vvt/GreenhouseProject/README.md

<h1>Introduction/Вступление</h1>

Arduino based smart greenhouse - is the project, intended to provide fully automatic way to control your greenhouse with many tasty features, like MQTT, Wi-Fi, Web-based interface, IoT (ThingSpeak, GardenBoss.ru), configuration software and so on.

Умная теплица на Arduino - проект прошивки, позволяющей вам полностью автоматизировать вашу теплицу, и включающий в себя многие вкусные плюшки, такие как поддержка MQTT, работу через Wi-Fi, работу с IoT (ThingSpeak, GardenBoss.ru), веб-интерфейс, конфигуратор, и многое другое.

<h1>NB: to English readers</h1>
<p>
Need volunteers to help with translating the interface into English (configurator, web-interface, firmware settings, project description on GitHub, and so on). For details, please write to <a href="mailto:spywarrior@gmail.com">spywarrior@gmail.com</a> - English is not my native language, I can translate from Russian to it, but with permanently bad results :(.

<h1>About/О проекте</h1>

<ul>
 <li><a href="README_EN.md">English description of the project</a></li>
 <li><a href="README_RU.md">Русская версия описания проекта</a></li>
 </ul>
