vvt/GreenhouseProject/plan.png

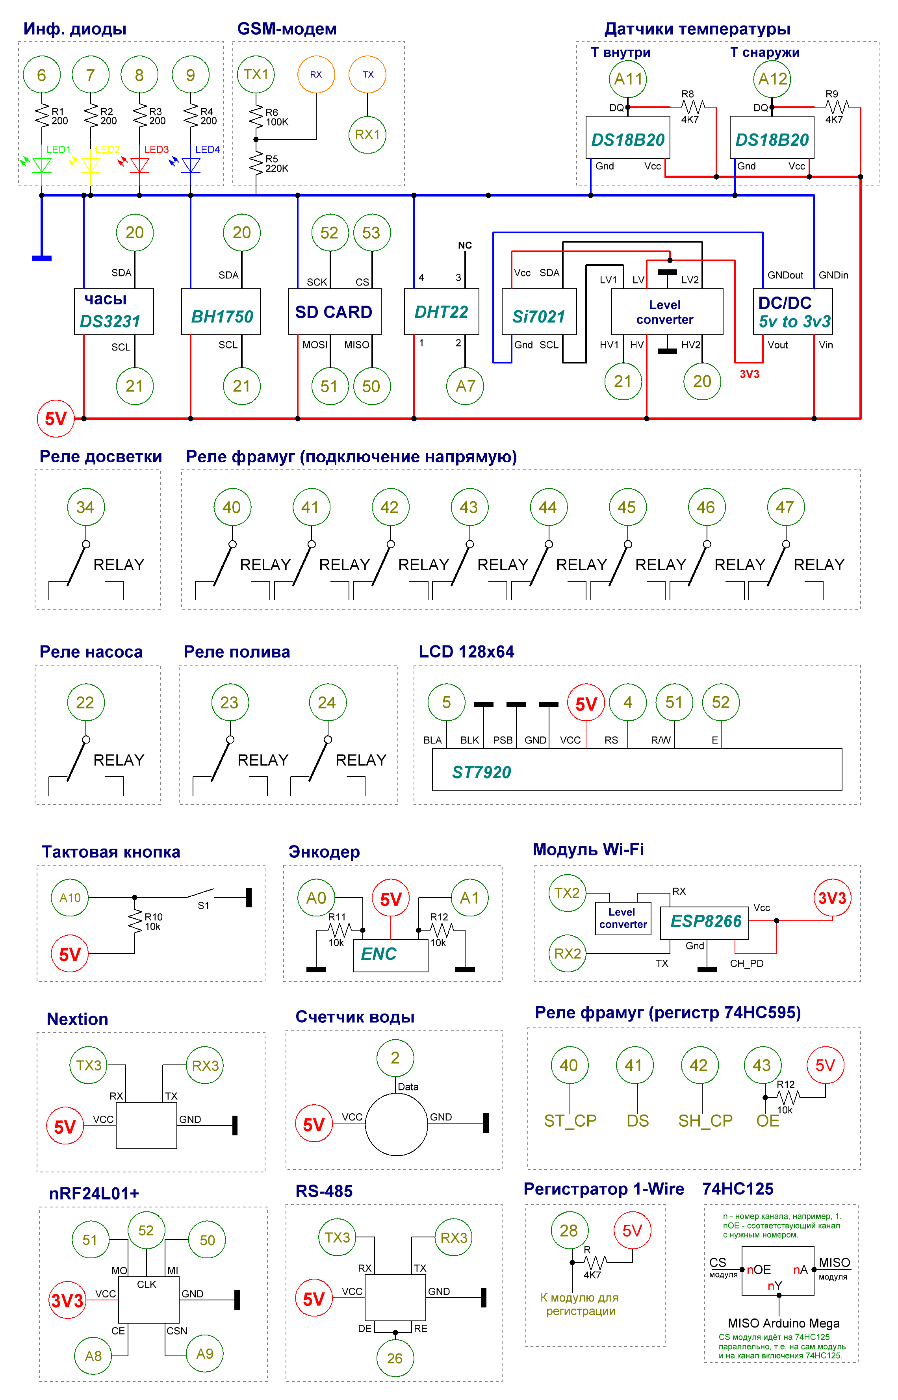
plan.png
