vvt/GreenhouseProject/plan_en.png

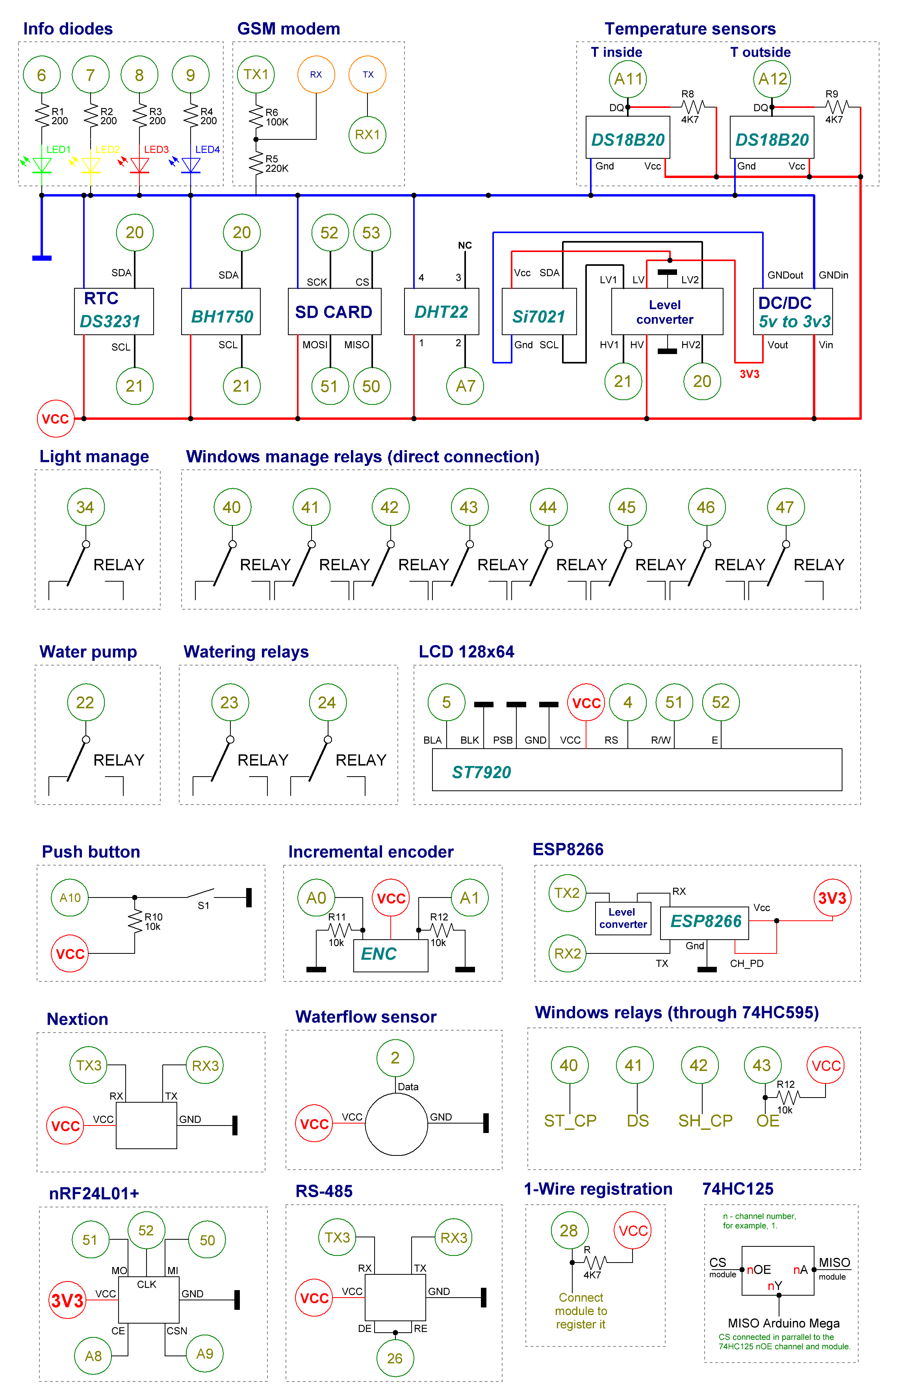
plan_en.png
