vvt/GreenhouseProject/screen1.png

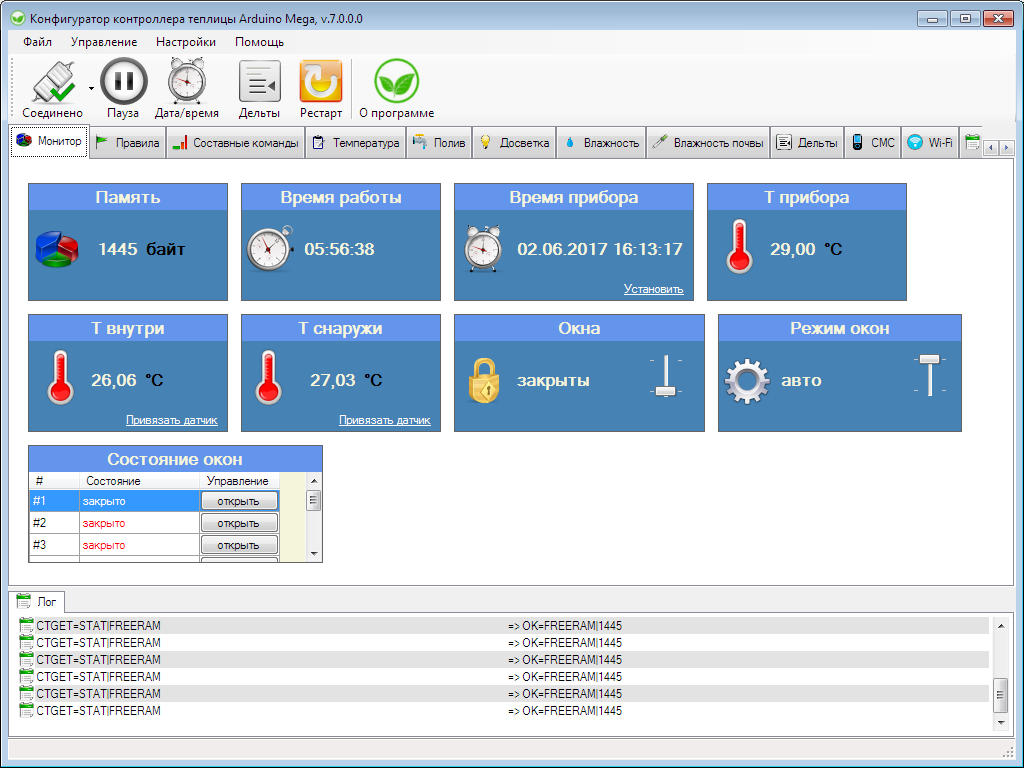
screen1.png
