vvt/GreenhouseProject/screen1_en.png

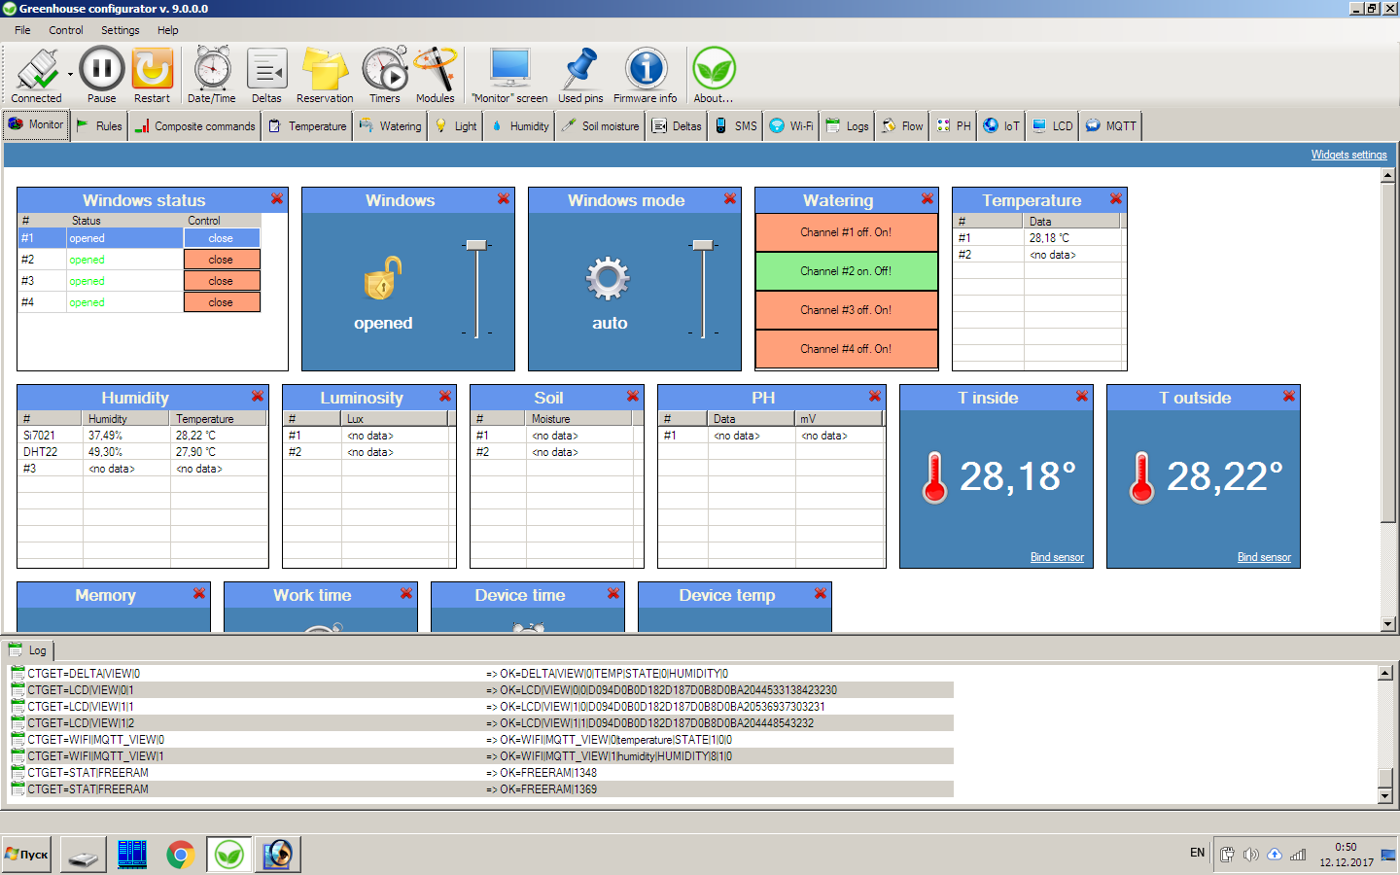
screen1_en.png
