vvt/GreenhouseProject/screen2.png

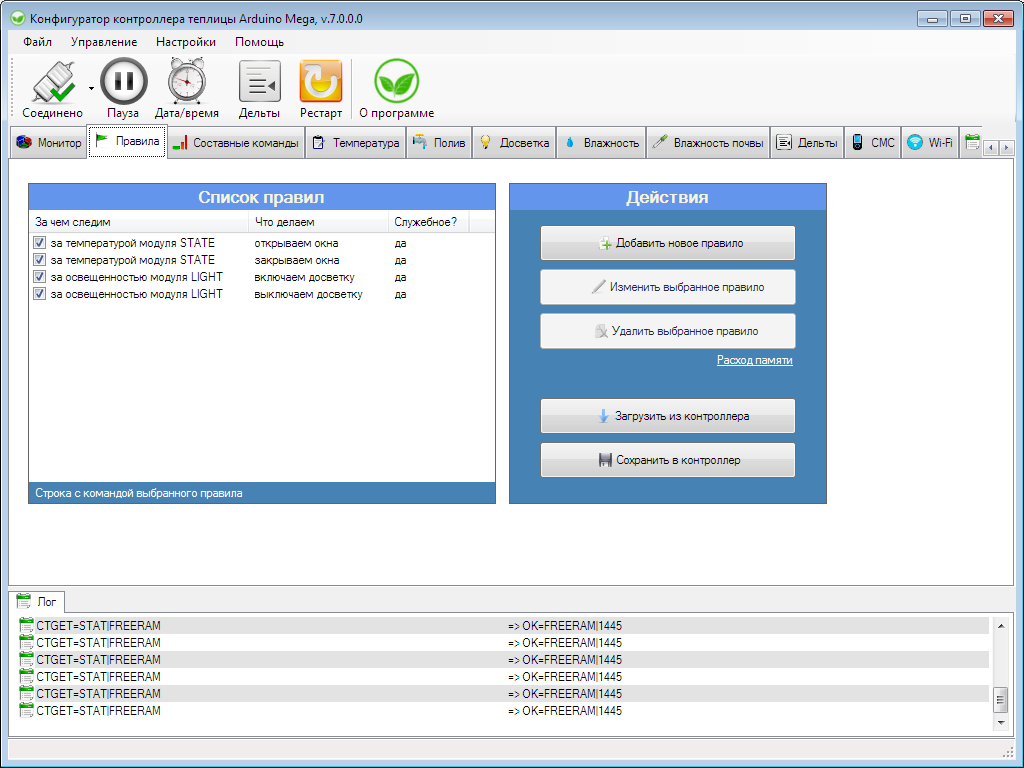
screen2.png
