vvt/GreenhouseProject/screen2_en.png

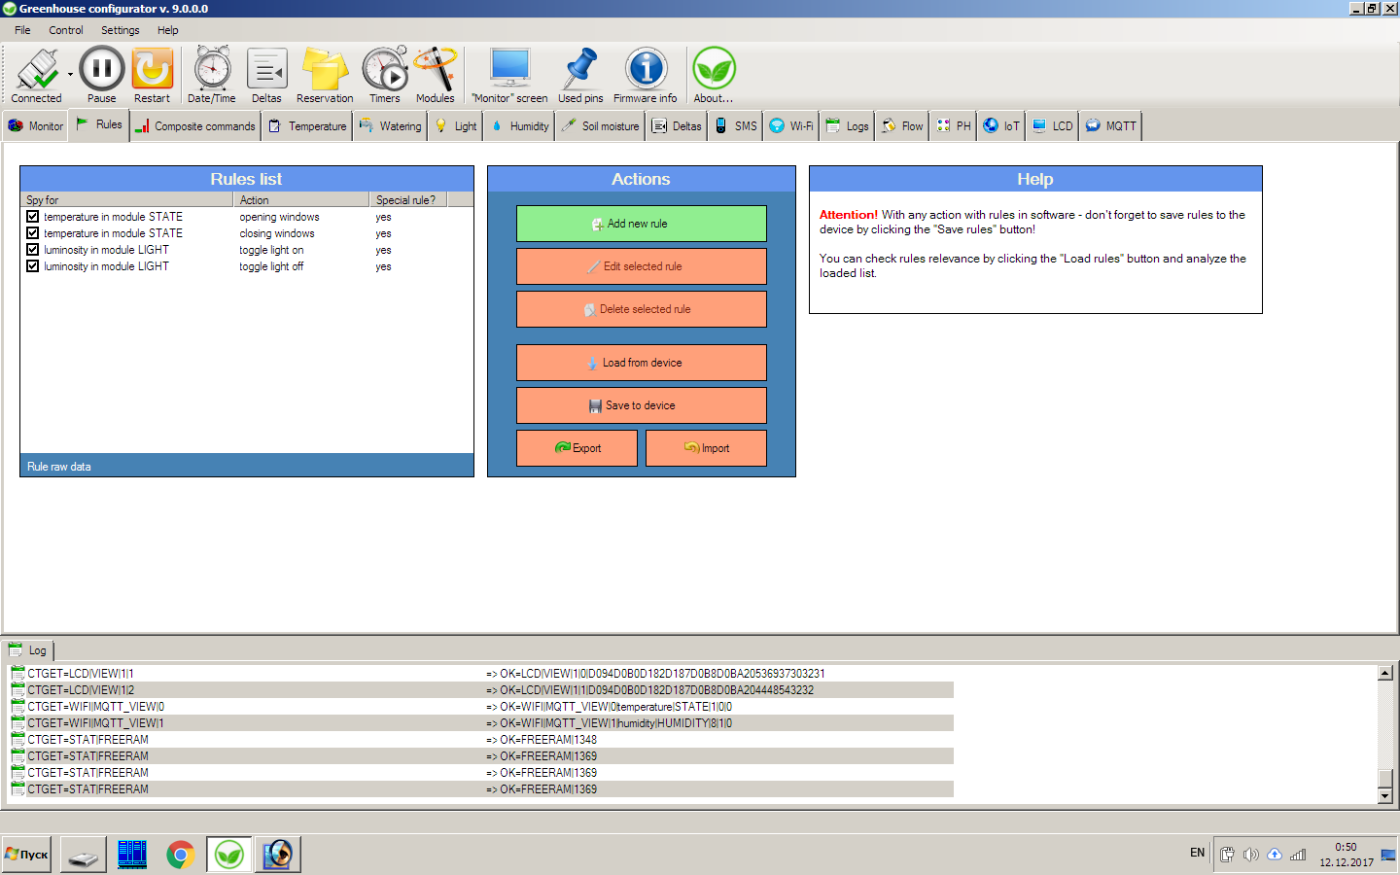
screen2_en.png
