vvt/GreenhouseProject/screen3.png

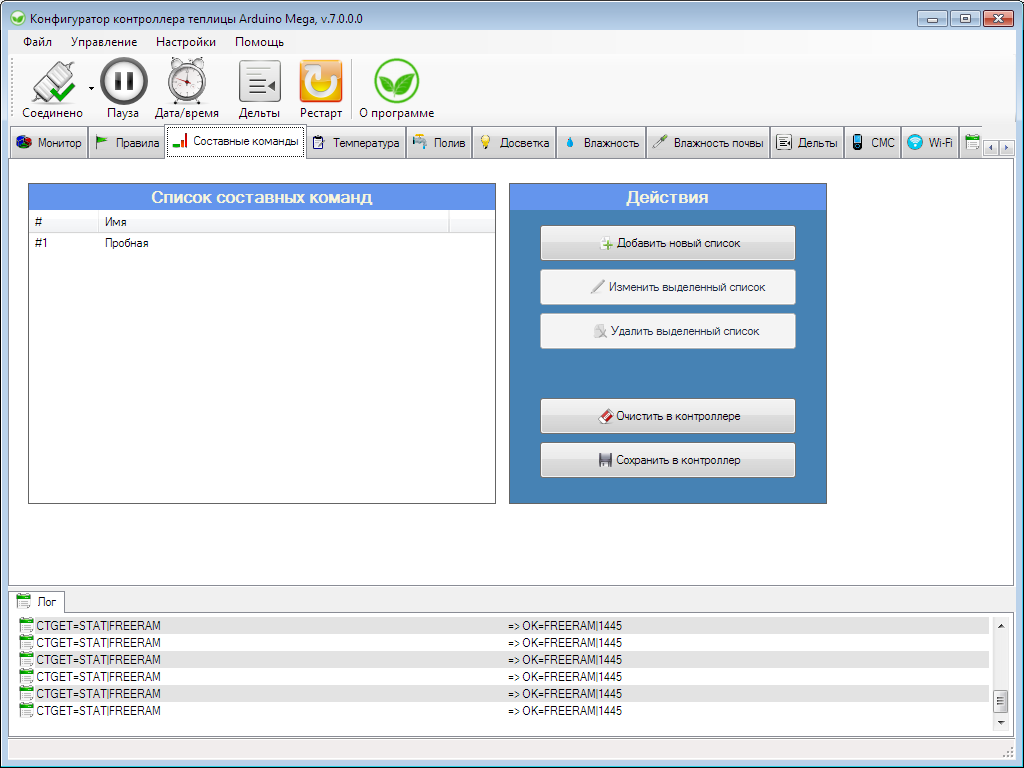
screen3.png
