vvt/GreenhouseProject/screen3_en.png

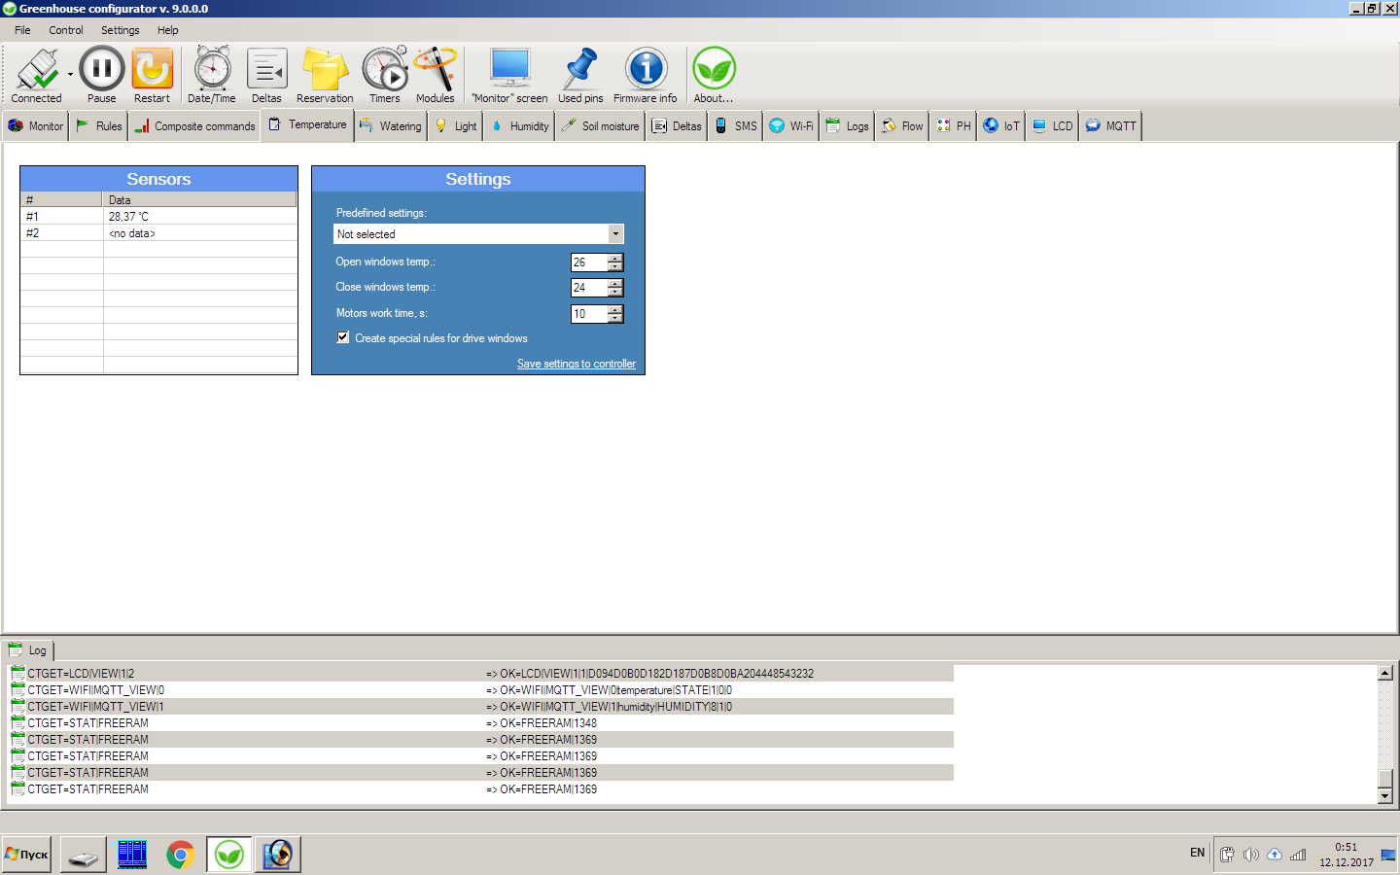
screen3_en.png
