vvt/GreenhouseProject/screen4.png

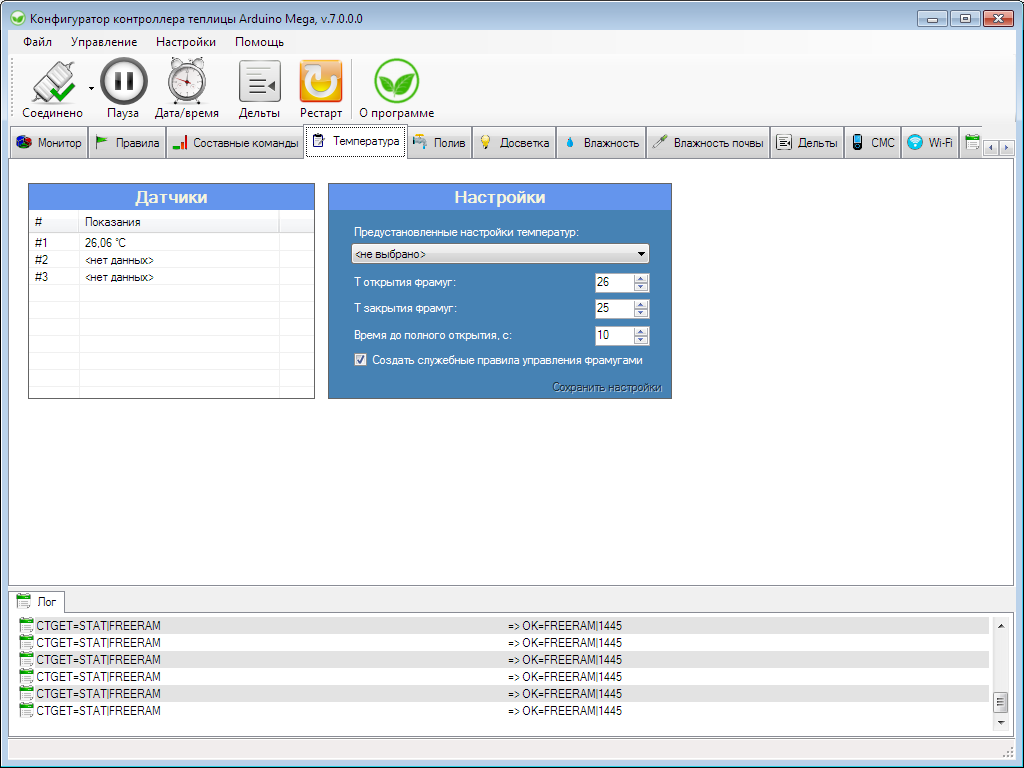
screen4.png
