vvt/GreenhouseProject/screen4_en.png

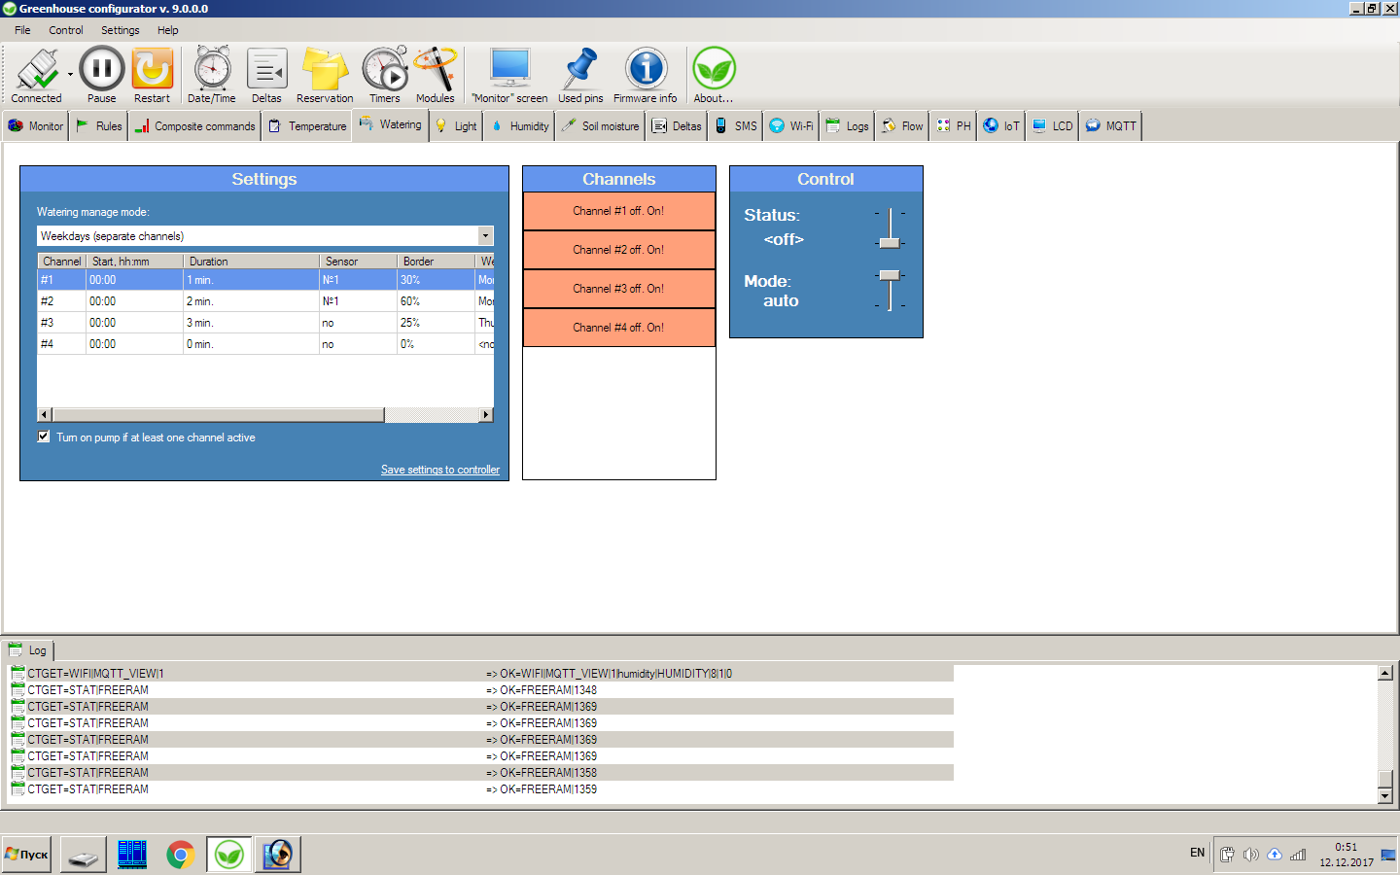
screen4_en.png
