vvt/GreenhouseProject/screen5.png

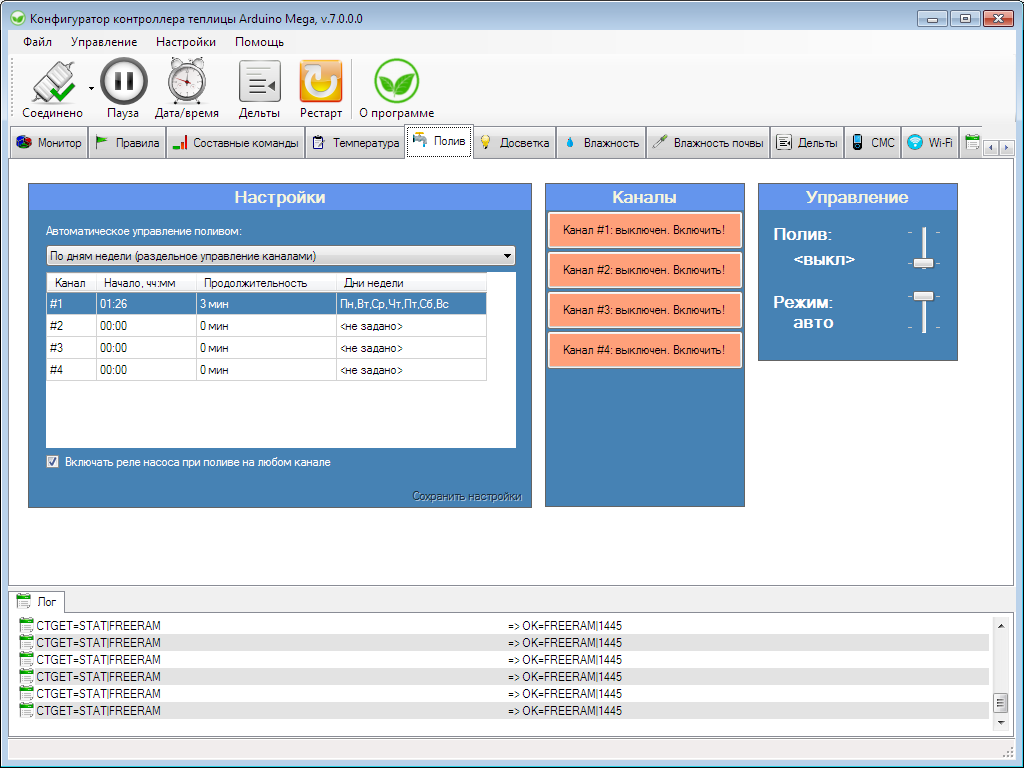
screen5.png
