vvt/GreenhouseProject/screen5_en.png

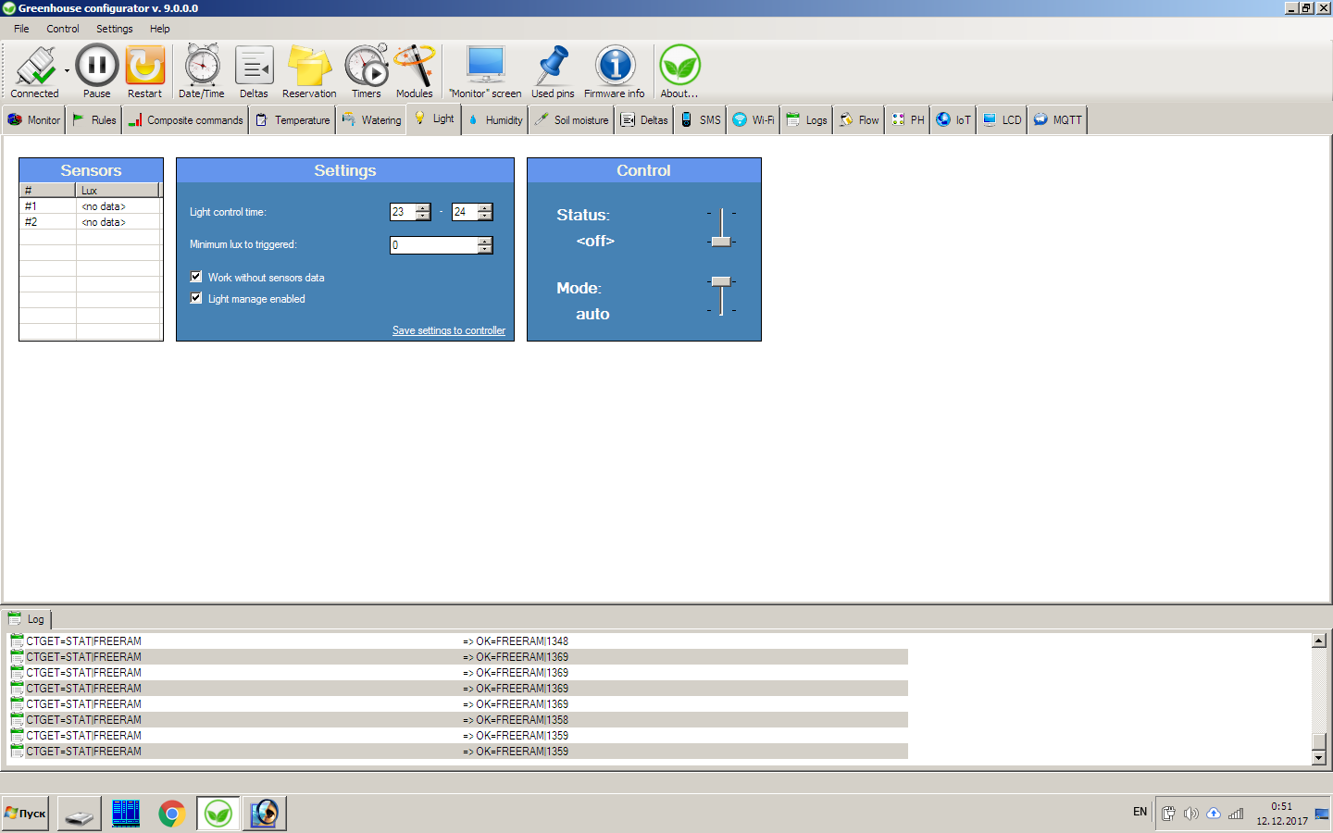
screen5_en.png
