vvt/GreenhouseProject/screen6.png

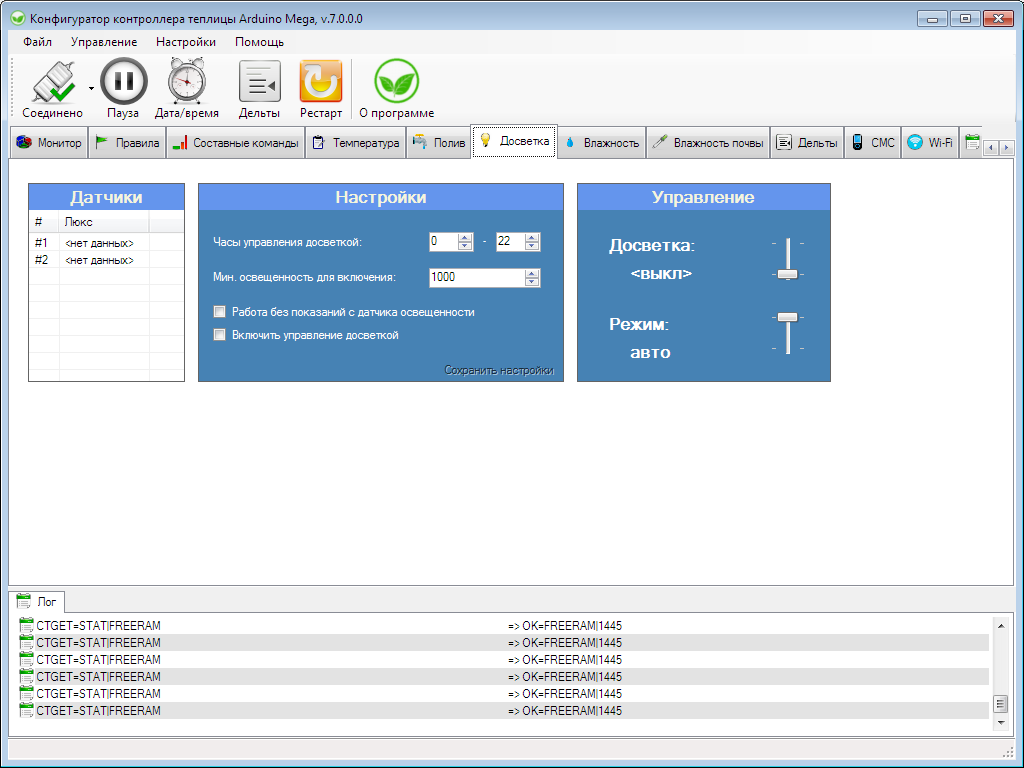
screen6.png
