vvt/GreenhouseProject/screen6_en.png

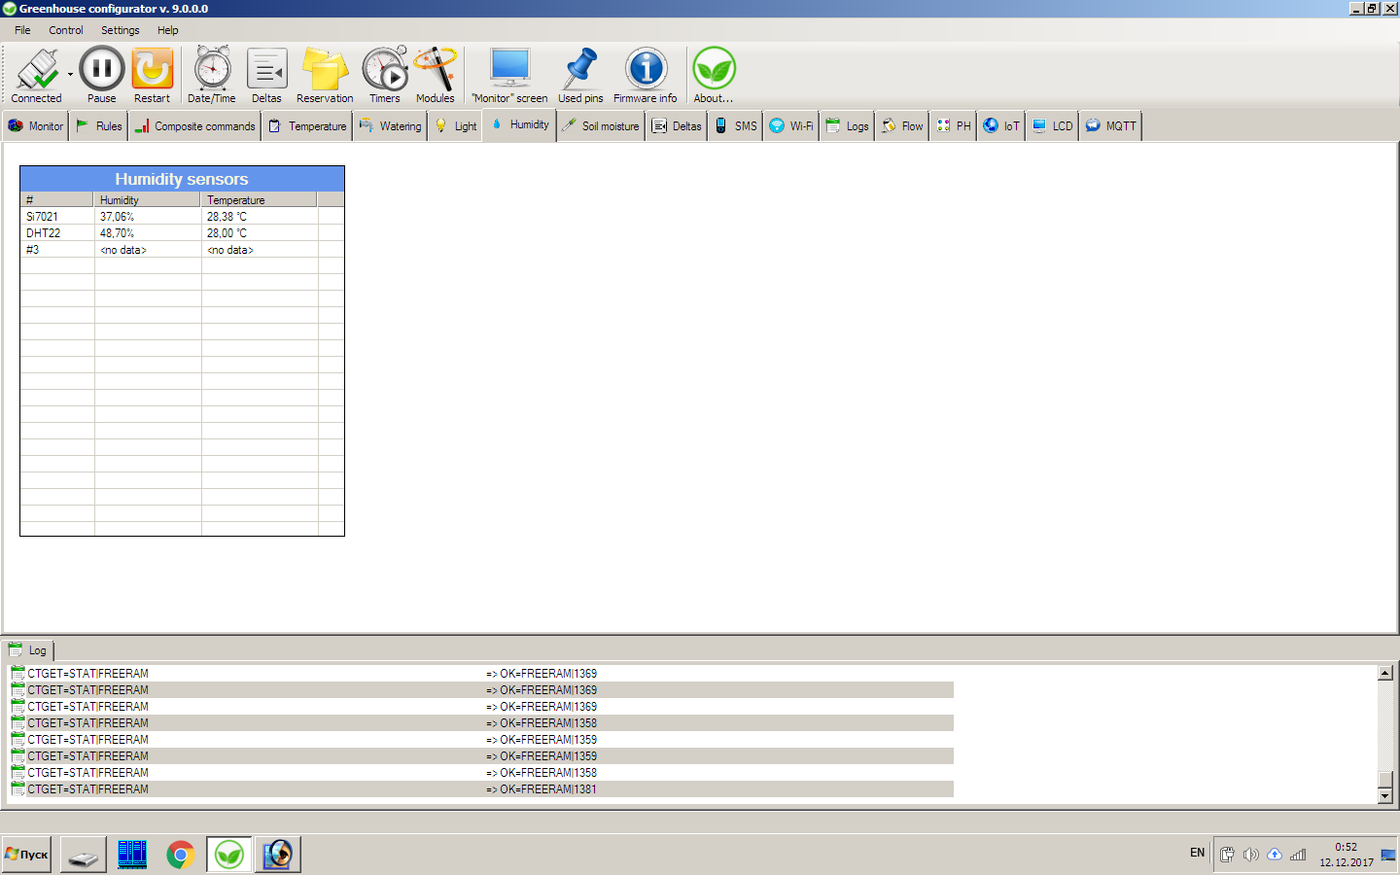
screen6_en.png
