vvt/GreenhouseProject/screen7.png

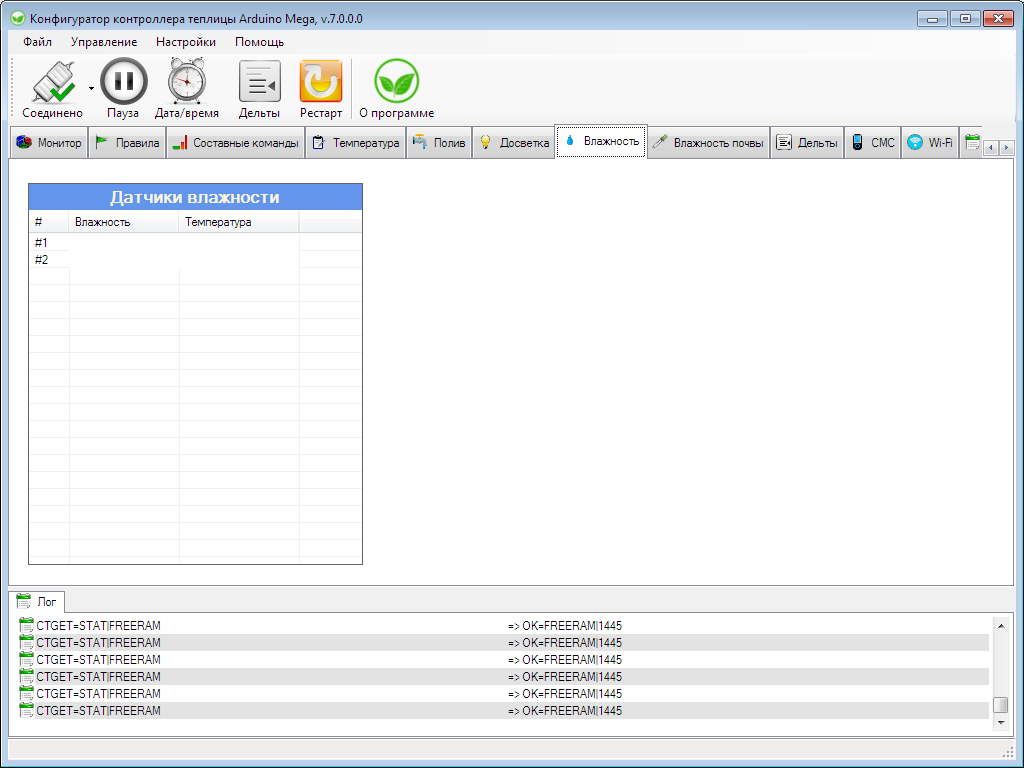
screen7.png
