vvt/GreenhouseProject/screen7_en.png

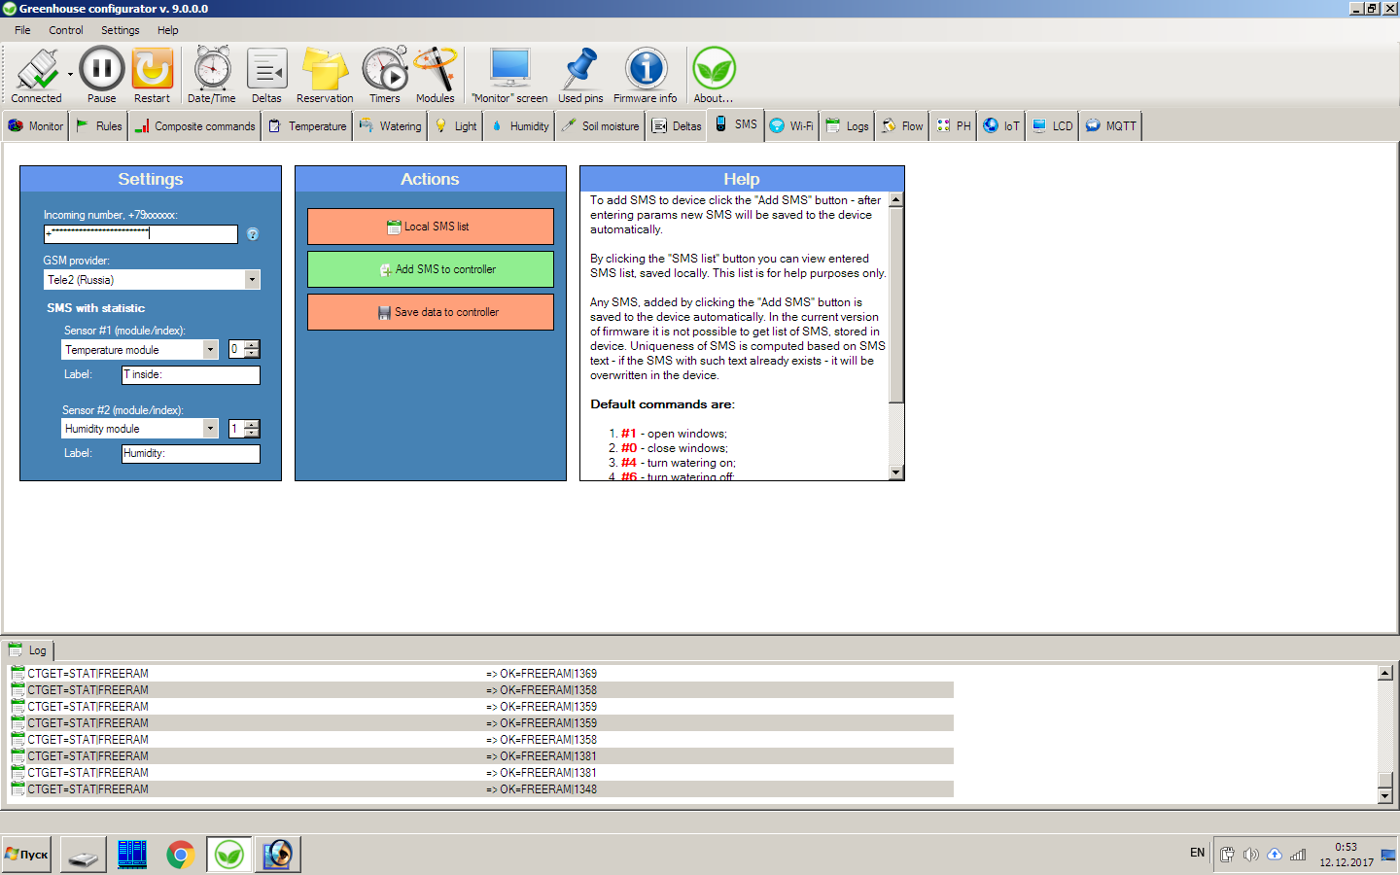
screen7_en.png
