vvt/GreenhouseProject/screen8.png

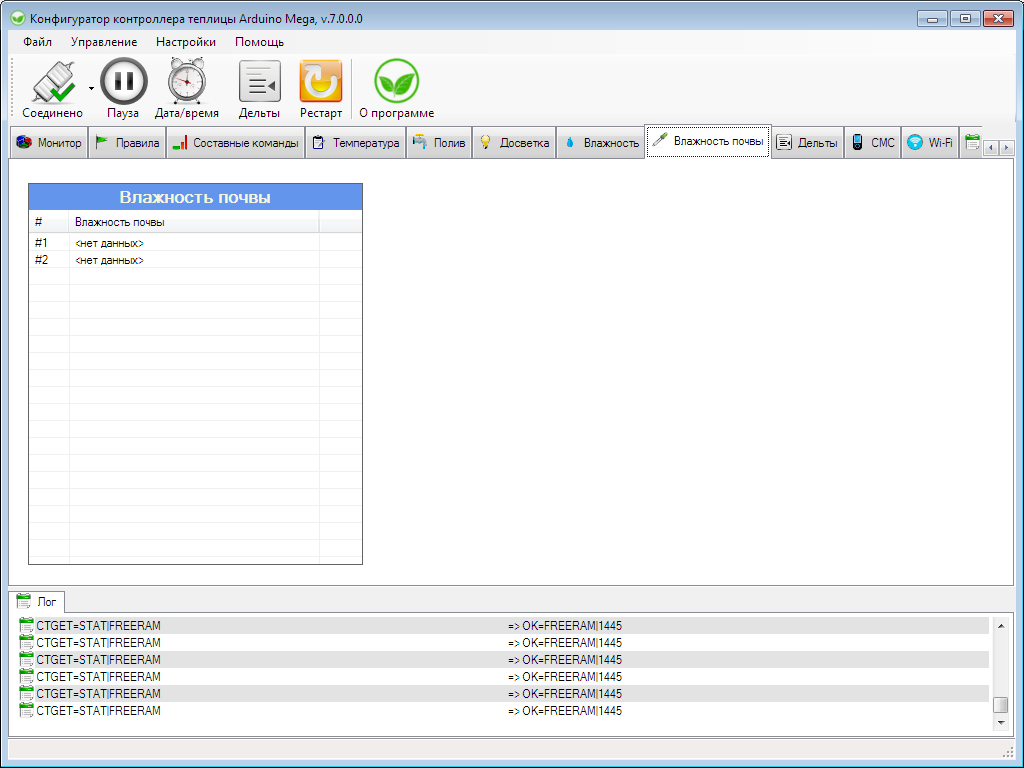
screen8.png
