vvt/GreenhouseProject/screen8_en.png

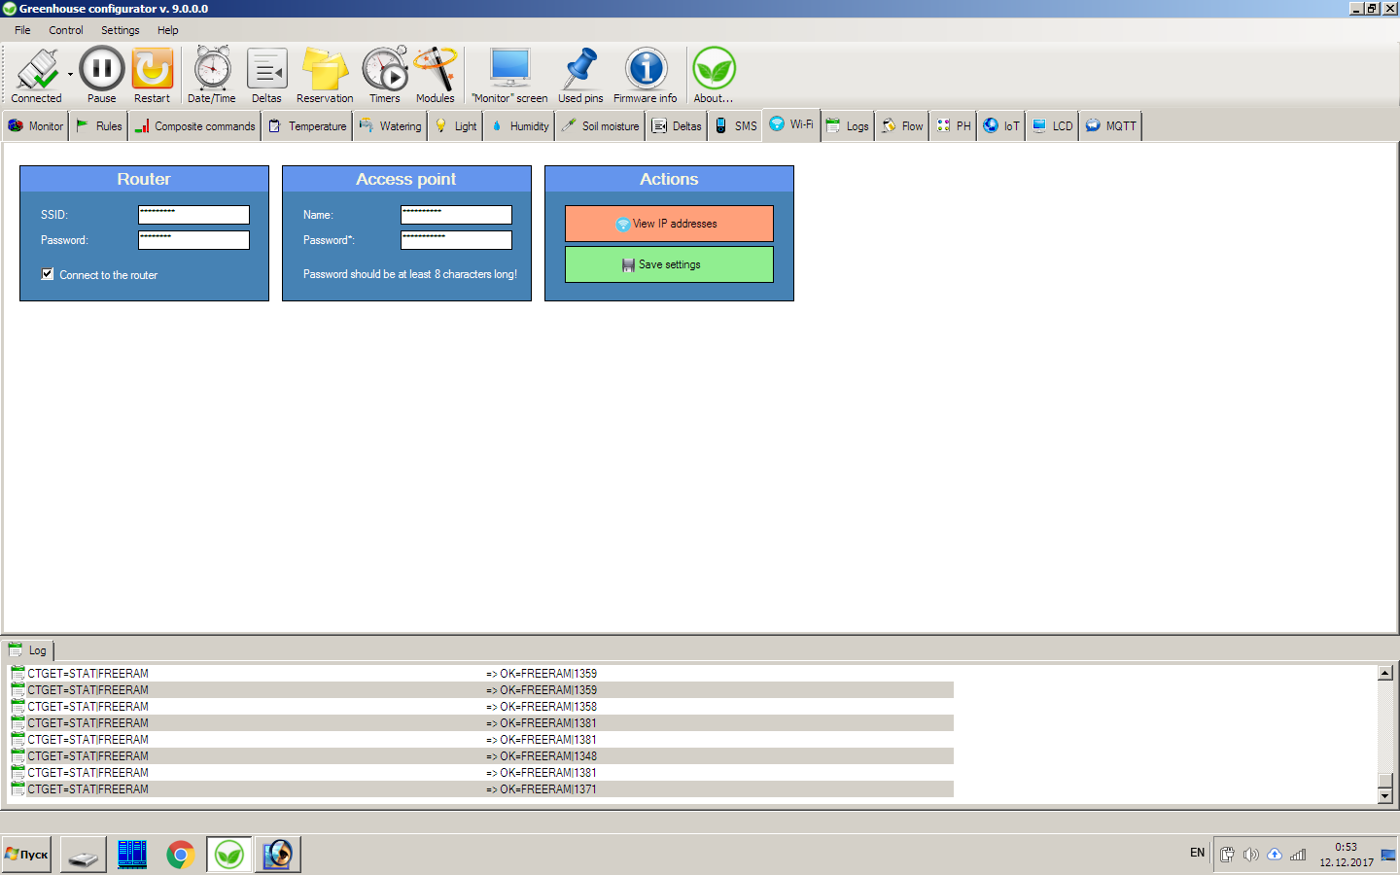
screen8_en.png
