vvt/GreenhouseProject/screen9_en.png

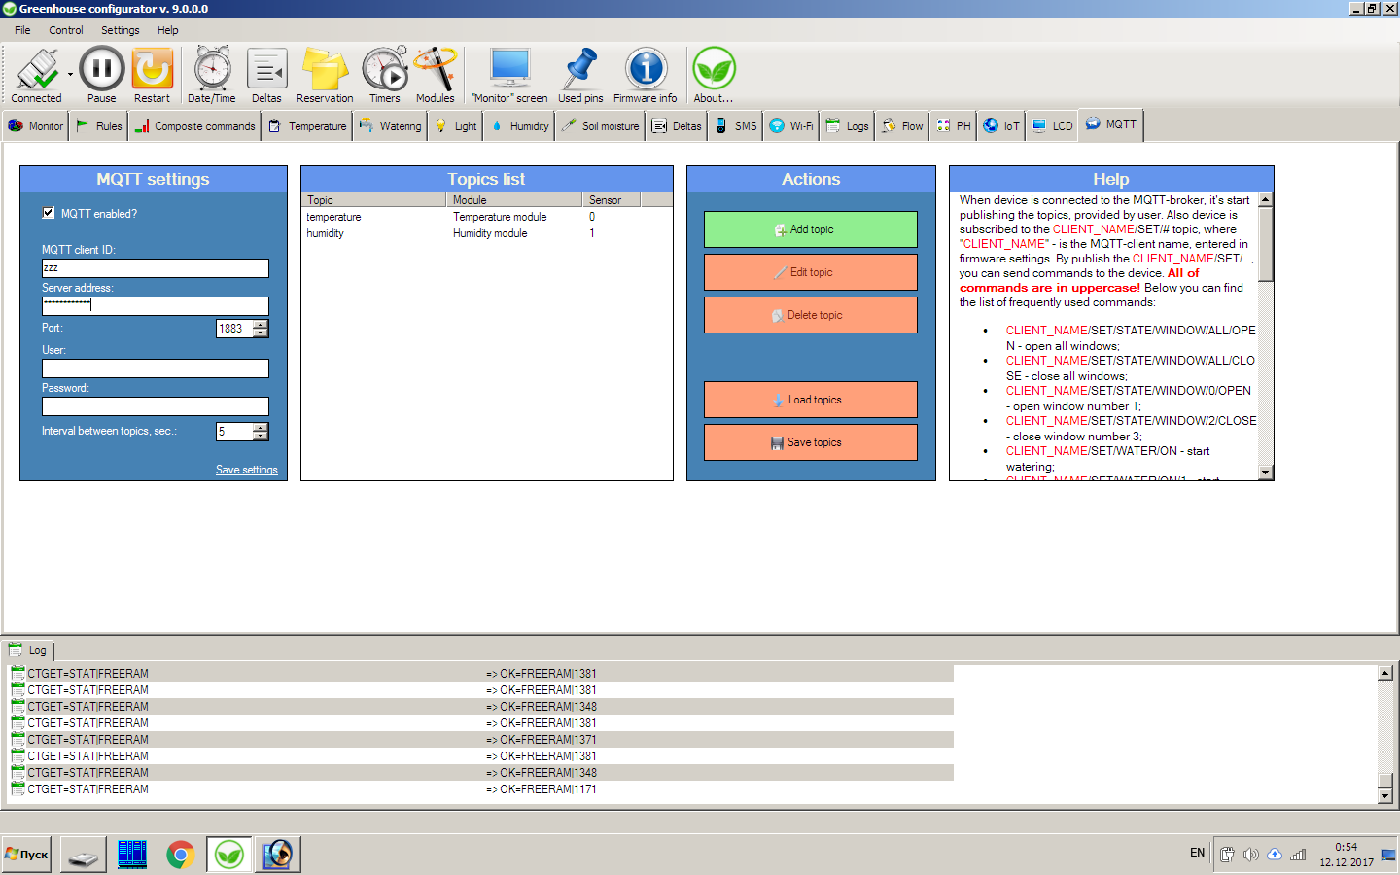
screen9_en.png
