vvt/GreenhouseProject/screen10.png

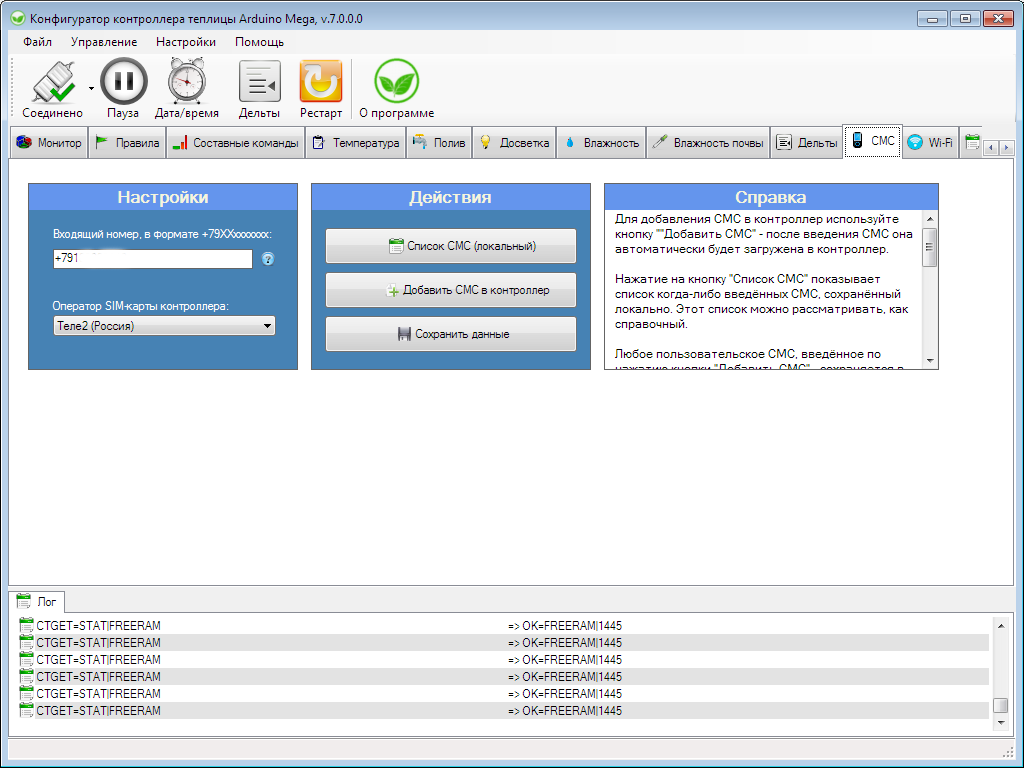
screen10.png
