vvt/GreenhouseProject/screen11.png

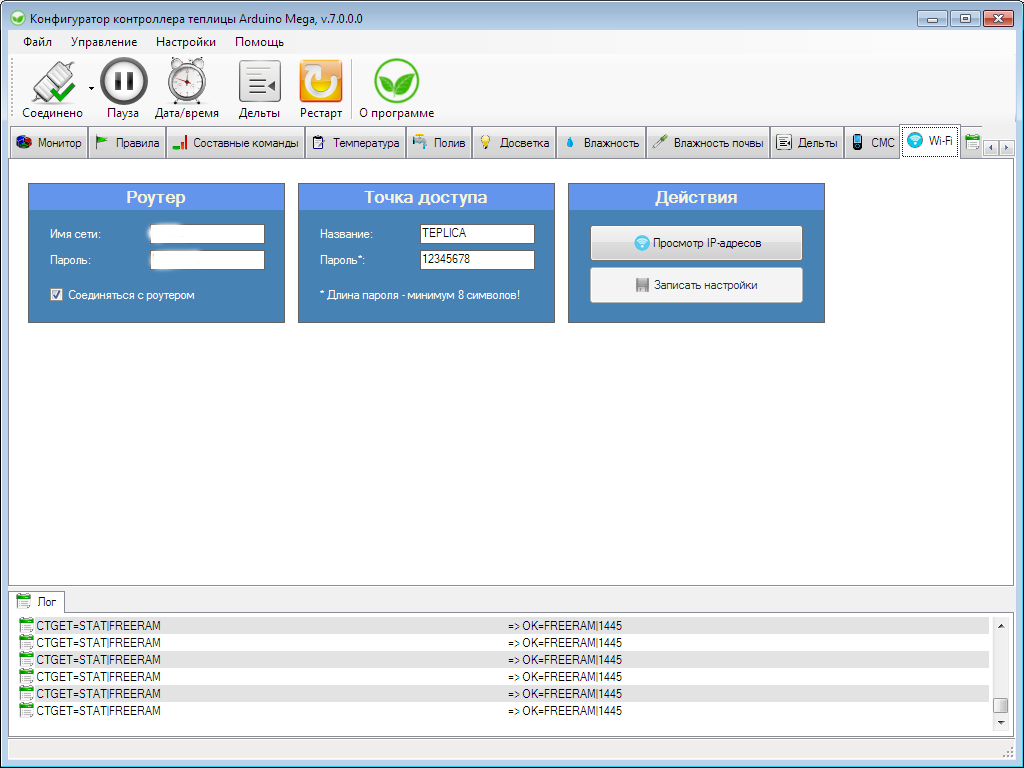
screen11.png
