vvt/GreenhouseProject/screen12.png

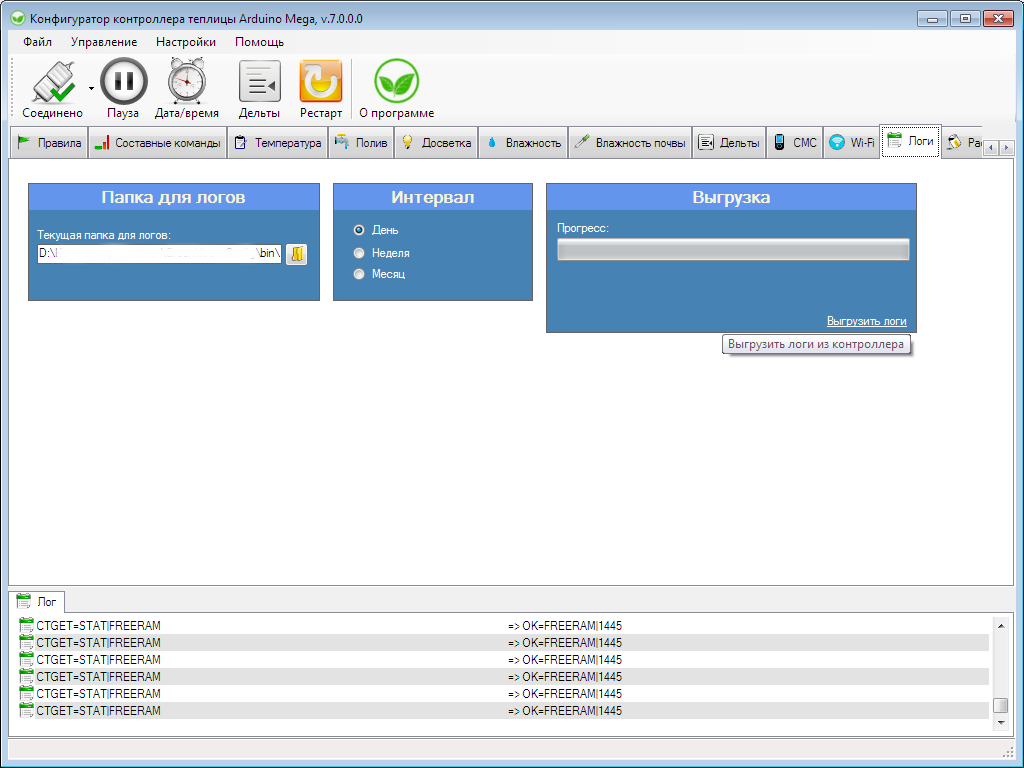
screen12.png
