vvt/GreenhouseProject/screen13.png

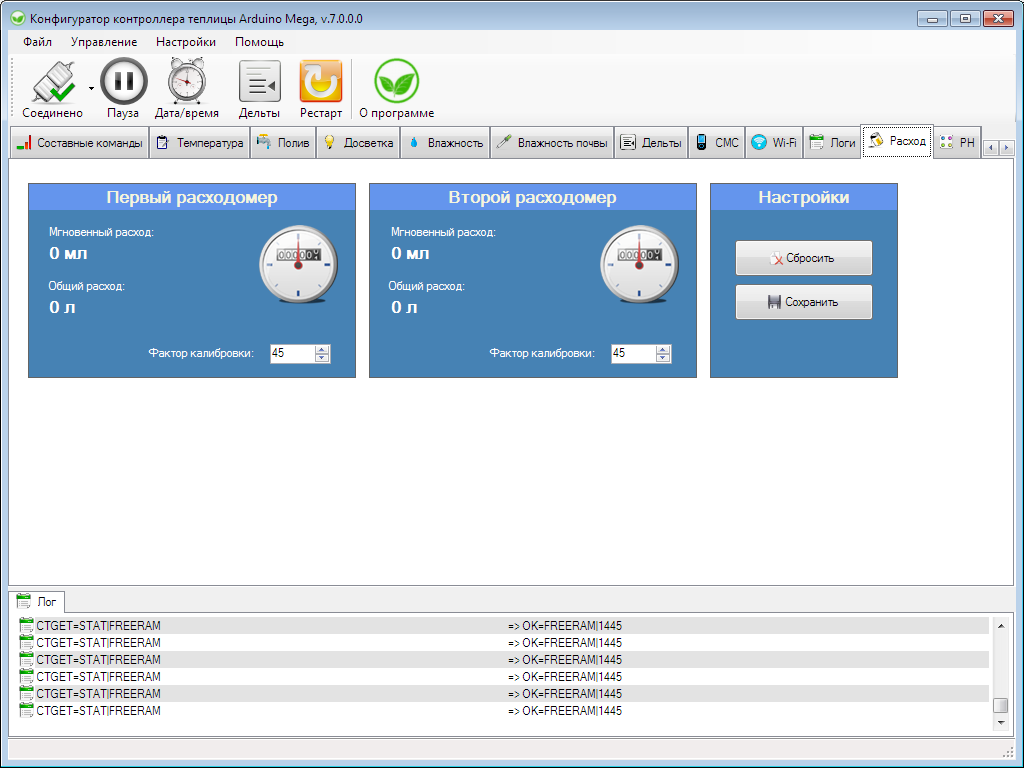
screen13.png
