vvt/GreenhouseProject/screen14.png

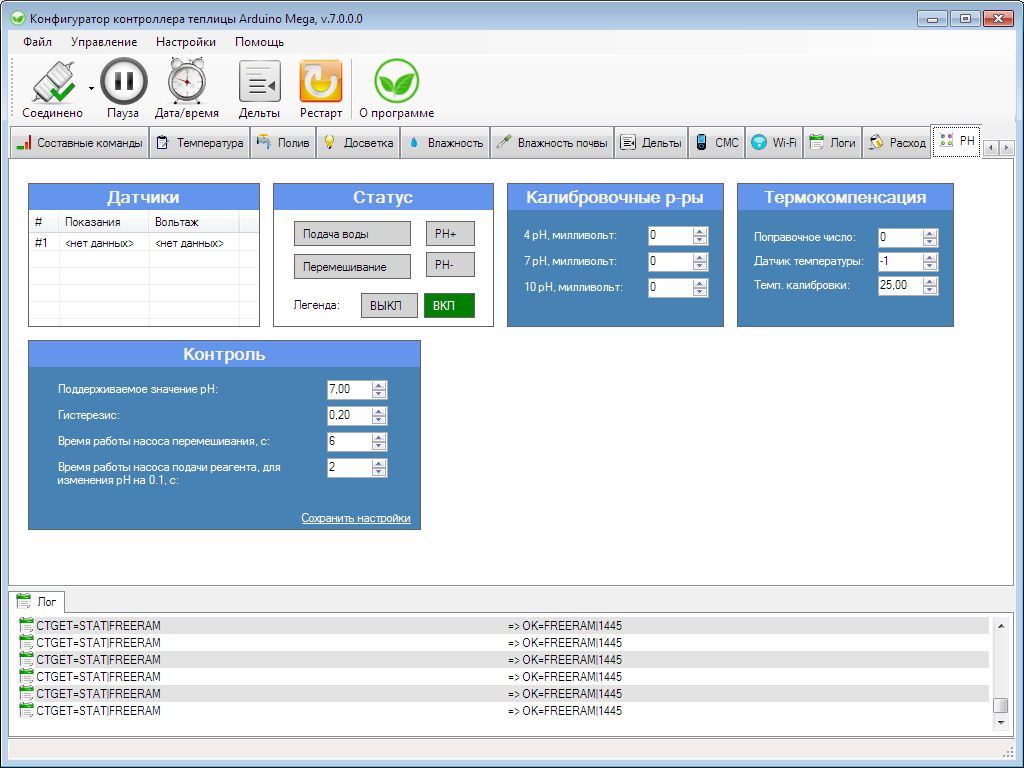
screen14.png
