vvt/GreenhouseProject/screen15.png

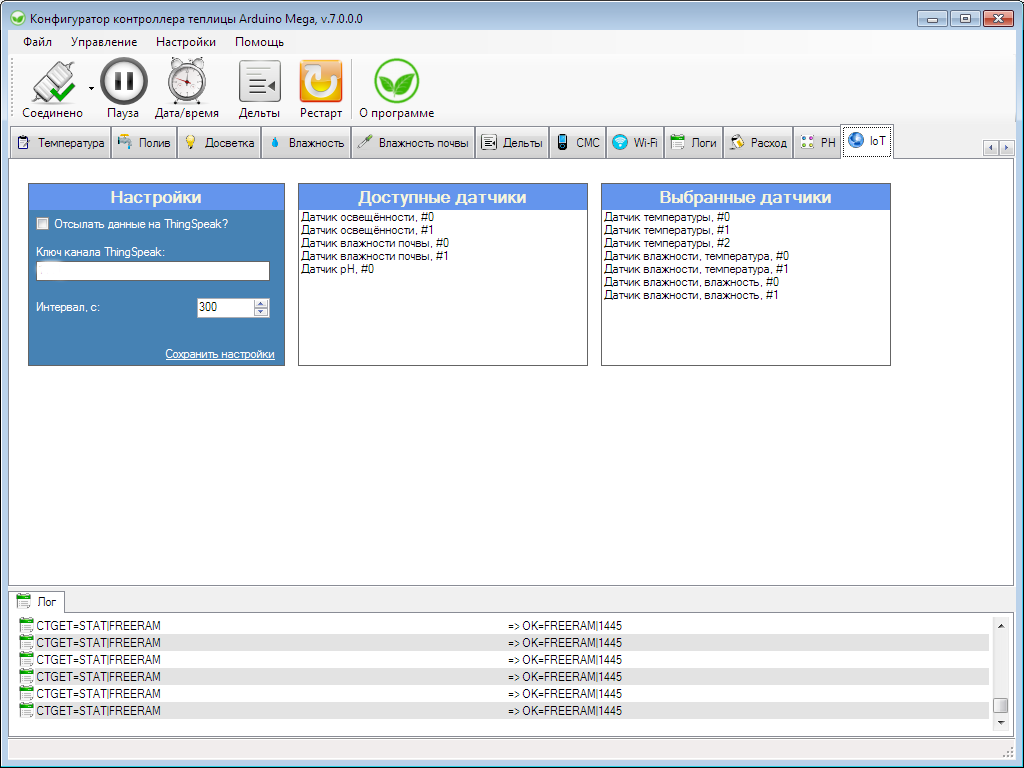
screen15.png
