vvt/GreenhouseProject/screen16.png

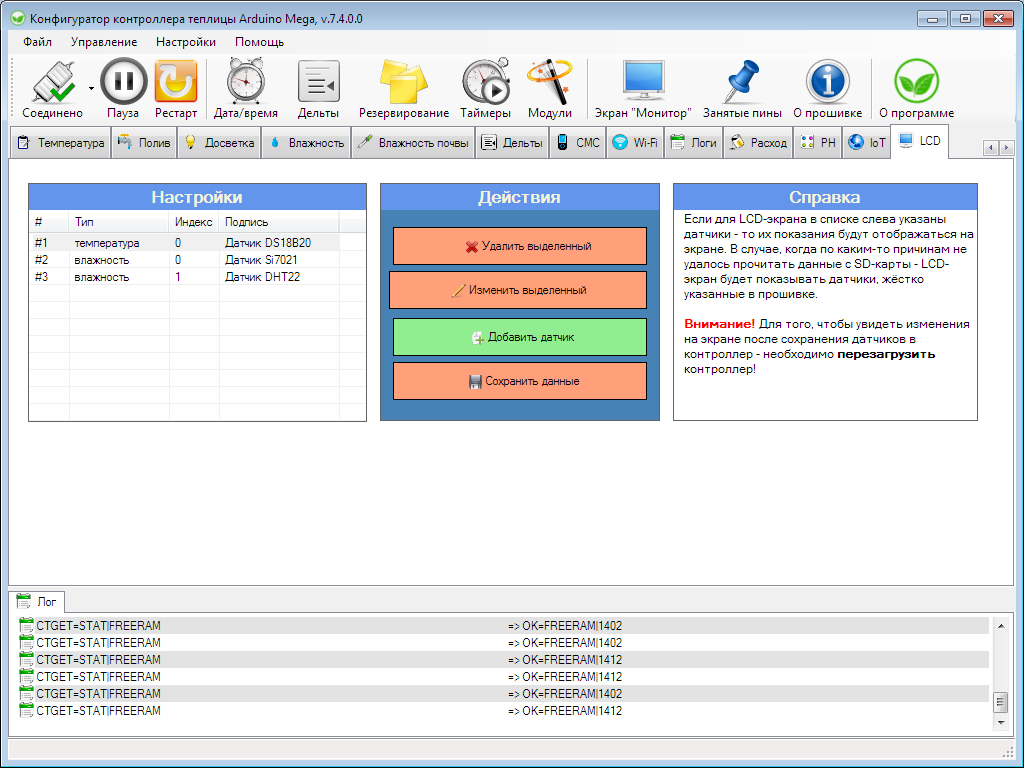
screen16.png
