vvt/GreenhouseProject/(list of files, drawings)

Other design files:
NewPlan_en.spl7
NewPlan_ru.spl7
