vvt/GreenhouseProject/(commit log)

2016-07-14 Работа универсального исполнительного модуля по шине RS-485
2016-07-15 Поправил ошибку работы исполнительного модуля
2016-07-15 Работа универсальных модулей с датчиками по RS-485
2016-07-15 Сброс показаний со счётчиков расхода воды
2016-07-17 Настройки конфигуратора
2016-07-23 Работа универсальных модулей по радиоканалу
2016-07-23 Выложил библиотеку для nRF
2016-07-23 Игнорирование моргающих светодиодов при отсылке пакета по радио
2016-07-25 Немного энергосбережения при работе по радиоканалу
2016-07-25 Энергосбережение для датчиков на I2C
2016-07-25 Отрубание питания линий с управляющего пина - энергосбережение
2016-07-25 Настройки RS-485 и nRF в Globals.h
2016-07-26 Подправил комментарии к настройкам
2016-07-27 Настройки прошивки под 8МГц
2016-07-28 Отладочное сообщение.
2016-07-28 Поправил директиву подключения
2016-07-30 Поправил план и чуть подпилил SMS-модуль
    [NewPlan.spl7]
2016-08-01 Обновил схему
    [NewPlan.spl7]
2016-08-01 Проверка на инициализацию nRF
2016-08-02 поправил настройки условной компиляции
2016-08-02 Статус "нет данных", если с датчиков по радиоканалу долго не поступали сведения
2016-08-02 Исправление показаний с универсального датчика влажности
    [UniversalSensors.cpp, UniversalSensorsModule.ino]
2016-08-02 Проверил работу Si7021 на универсальном модуле
2016-08-03 Поддержка китайских датчиков влажности почвы для универсальных модулей
2016-08-03 Поддержка датчиков DHT* в универсальном модуле
2016-08-04 Модуль контроля pH - первая версия
2016-08-05 Правки работы с pH и nRF
2016-08-15 Вычисление pH в зависимости от факторов калибровки
2016-08-15 Показания pH в милливольтах в вебморде
2016-08-16 Поправил расчёт pH
2016-08-16 Исправил ошибку несброса данных с датчика pH в вебморде
2016-08-17 Добавил обработку ошибок в конфигураторе
2016-08-20 Настройки контроля pH в конфигураторе и вебморде
2016-08-20 Первая версия контроля pH
2016-08-20 Состояние модуля контроля pH в конфигураторе и вебморде
2016-08-24 Поправил ошибку вылета конфигуратора
2016-08-25 Настройки при регистрации универсальных модулей
2016-08-25 Статус регистрации универсальных модулей
2016-09-09 Обновил Globals
2016-09-11 Инициализация структуры
2016-09-14 Правки по Si7021 и модулю таймеров
2016-09-27 Правка модуля полива
2016-12-02 Выложил исходники конфигуратора
2016-12-02 Update Железо, используемое в проекте.txt
2017-01-09 Поправил отображение отрицательных температур
2017-01-29 Потихоньку обновляю настройки прошивки в соответствии с разводкой платы
    [NewPlan.spl7]
2017-01-29 Поправил ошибку опроса датчиков влажности
2017-02-17 Поправил команду для GSM-модема
2017-02-27 Добавление контроллера в вебморде
2017-02-27 удалил вывод в консоль
2017-03-01 Информация по занятым пинам в конфигураторе
2017-03-05 Перевёл клиентский 1-Wire на новую библиотеку
2017-03-07 Описание к занятым пинам в конфигураторе
2017-03-07 Рефакторинг SMS-модуля, правка ошибок
2017-03-09 Наброски запроса баланса
2017-03-09 Больше отладочной информации для GSM
2017-03-10 Оптимизация работы с памятью
2017-03-10 Получение баланса
2017-03-10 Управление питанием GSM-модема
2017-03-10 Оптимизация загрузки оперативки
2017-03-11 Битва за оперативку
2017-03-13 Максимальный номер пина для слежения в правилах
2017-03-13 Попытка заставить вебморду работать под говнобраузером IE
2017-03-15 Первая версия поддержки ThingSpeak
2017-03-16 Настройки IoT в конфигураторе и вебморде
2017-03-17 Вторая версия настроек IoT
2017-03-17 Настройки оператора GSM
2017-03-19 Отсыл данных на ThingSpeak через Neoway M590
2017-03-22 Отсыл данных на ThingSpeak через SIM800
2017-03-22 Поправил запрос баланса для SIM800
2017-03-22 Поправил обработку СМС
2017-03-23 Виртуальные пины
2017-03-24 Тревоги, первая версия
2017-03-25 Поправил показания с DHT22
2017-03-28 Обновление вебморды
2017-04-06 Частотный датчик влажности почвы
2017-04-28 Внешний ватчдог + управление питанием модулей
2017-05-02 Обрезаем СМС, если она превышает 70 символов
2017-05-03 багфикс
2017-05-14 Небольшие правки
2017-05-15 Перешёл на другую библиотеку для модуля влажности
2017-05-15 Новая библиотека для Si7021 в прошивке универсального модуля
2017-05-18 Поддержка SHT10
2017-05-18 Поддержка SHT10 для универсального модуля
2017-05-25 Поддержка работы модулей полива и досветки через MCP23S17 и MCP23017
2017-05-26 Расширил каналы полива до 16 + управление вторым насосом для полива
2017-05-27 Глобальный редизайн модуля полива
2017-05-29 Перевёл настройку времени начала полива на часы и минуты
2017-05-31 Правка модуля pH
2017-05-31 Не заметил косячка мелкого, поправил
2017-06-01 Первые потуги переделывания интерфейса конфигуратора
2017-06-01 Поправил ошибку выдачи значений pH
2017-06-02 Редизайн конфигуратора
2017-06-02 Добавил кнопок на тулбар конфигуратора + скетч для очистки EEPROM
2017-06-03 Игнорирование температуры прибора в графиках вебморды
2017-06-03 Периодическое обновление графиков в вебморде
2017-06-03 Продолжаем работать над редизайном конфигуратора
2017-06-04 Запрос команд с внешнего сервера через ESP + вынес работу с памятью отдельно
2017-06-05 Виджеты в конфигураторе
2017-06-05 Первая версия упорядочивания виджетов мышой
2017-06-06 Поддержка EEPROM-памяти AT24Cx
2017-06-06 Причёсывание конфигуратора. Изъял исходники конфигуратора.
2017-06-06 Два новых экрана для LCD + допилинг конфигуратора + багфикс
2017-06-07 Настройка датчиков на LCD из конфигуратора
2017-06-08 Подровнял кнопку в конфигураторе, неаккуратненько было
2017-06-08 Поправил ошибку с зависимостями условной компиляции
2017-06-08 Переделал последнее окно со старым дизайном
2017-06-08 Уменьшил размер окна правил
2017-06-09 Привязка своих имён датчиков в конфигураторе
2017-06-10 Ключ доступа к WEB API в конфигураторе и прошивке
2017-06-11 Флаг активности HTTP API в конфигураторе и прошивке
2017-06-13 Передача локального времени контроллера при проверке команд на сервере
2017-06-13 Сохранение часового пояса в контроллере
2017-06-14 Отсыл данных с датчиков на сервис
2017-06-18 Изменил адрес HTTP-сервиса
2017-06-18 Добавил настройки HTTP API в вебморду
2017-06-19 Поправил ошибку адреса скрипта сервиса
2017-06-19 Поправил ошибку создания запроса к сервису
2017-06-19 Переинициализация DS18B20 после включения питания
2017-06-19 Сканирование несущих nRF
2017-06-19 Добавил настройку auto ack в прошивку
2017-06-20 Добавил отладочной информации
2017-06-20 Оптимизация
2017-06-21 Работа с сервисом gardenboss.ru через GSM
2017-06-21 Новая команда для сервиса gardenboss - перейти в автоматический режим
2017-06-21 Поправил ошибку передачи влажности почвы на сервер
2017-06-22 Увеличил максимальный интервал опроса универсальных датчиков в конфигураторе
2017-06-23 Новые поддерживаемые SMS и команды для сервиса
2017-06-23 Управление пинами из конфигуратора + статус контроллера на сервис
2017-06-23 Косметика
2017-06-27 Выпилил библиотеку HTU21D
2017-06-27 Универсальные модули
2017-06-27 Модуль с датчиками
2017-06-27 Ошибка очерёдности вычитывания показаний по RS-485
2017-06-28 Работа информационных диодов через расширители портов
2017-06-29 Сохранение статуса полива каждые N минут
2017-06-29 Выключение полива по влажности почвы
2017-07-09 Поправил ошибку условной компиляции
2017-07-12 Кооперативная работа HTTP
2017-07-13 Автоматический реконнект ESP к роутеру
2017-07-13 Небольшой багфикс
2017-07-14 Доработка по ESP
2017-07-15 Фикс для Neoway
2017-07-15 Проверка на корректность диапазонов показаний датчиков
2017-07-16 Фикс модуля полива
2017-07-16 Фикс полива 2
2017-07-16 Фикс полива 3
2017-07-16 Отказался от дельты дополива
2017-08-14 Фикс отсыла данных на ThingSpeak
2017-08-18 Фикс сохранения настроек
2017-09-04 Первая версия настроек для Arduino Due
    [Configuration_DEBUG.h, Configuration_DUE.h, Configuration_MEGA.h, Configuration_Shared.h]
2017-09-04 Адаптация модуля расхода воды под Due.
    [Configuration_DUE.h, Configuration_MEGA.h]
2017-09-15 Настройки для мини-варианта платы под Mega
    [Configuration_MEGA_MiniBoard.h]
2017-10-06 Обновил настройки для мини-платы
    [Configuration_MEGA_MiniBoard.h]
2017-10-11 Настройки сравнения для правил
    [Configuration_DUE.h, Configuration_MEGA.h, Configuration_MEGA_MiniBoard.h]
2017-10-14 Экспорт/импорт правил в файл
2017-10-15 Настройки кол-ва попыток чтения датчика по RS485
    [Configuration_DUE.h, Configuration_MEGA.h, Configuration_MEGA_MiniBoard.h]
2017-10-19 Скрытие пароля роутера в конфигураторе и фикс вебморды
2017-10-21 Настройки HTTP API в вебморде
2017-10-21 Продолжаем причёсывать вебморду
2017-10-21 Продолжаем улучшать вебморду
2017-10-23 Глобальное обновление всего :)
2017-10-23 Поддержка датчика освещённости MAX44009
    [Configuration_DUE.h, Configuration_MEGA.h, Configuration_MEGA_MiniBoard.h]
2017-10-23 Поддержка Max44009 в универсальных модулях
2017-10-23 Обрезание верхней границы диапазона MAX44009, т.к. не вмещаемся в размерность хранимых данных
2017-10-23 Поддержка нескольких Si7021 одновременно
    [Configuration_DUE.h, Configuration_MEGA.h, Configuration_MEGA_MiniBoard.h]
2017-10-23 Фикс чтения с MAX44009
2017-10-24 Ещё один фикс для MAX44009
2017-12-09 Changed descriptions
    [NewPlan.spl7]
2017-12-11 MQTT support, multilanguage support and so on.
    [Configuration_DEBUG.h, Configuration_DUE.h, Configuration_MEGA.h, Configuration_MEGA_MiniBoard.h, Configuration_Shared.h]
2017-12-14 Using POWERKEY for SIM800, if necessary
    [Configuration_DUE.h, Configuration_MEGA.h, Configuration_MEGA_MiniBoard.h]
2017-12-14 SIM800 POWERKEY 2
2017-12-15 First version for Due with TFT support
    [Configuration_DUE.h, Configuration_Shared.h]
2017-12-15 New commands and able to GET queries through MQTT
    [Configuration_Shared.h]
2017-12-15 MQTT report as JSON object
    [Configuration_DUE.h, Configuration_MEGA.h, Configuration_MEGA_MiniBoard.h]
2017-12-16 Windows manage trough TFT
    [Configuration_DUE.h]
2017-12-16 Two new screens on TFT
    [Configuration_DUE.h, Configuration_MEGA.h, Configuration_MEGA_MiniBoard.h]
2017-12-17 Settings screen on TFT
    [Configuration_DUE.h]
2017-12-17 Limits settings in soft and web-interface
    [Configuration_DUE.h]
2017-12-18 Migrating to SdFat library
    [Configuration_DUE.h]
2017-12-18 Open interval settings on TFT
    [Configuration_DUE.h]
2017-12-19 Open ionterval on LCD + feedback for windows
    [Configuration_DUE.h]
2017-12-19 LCD labels moved to settings file
    [Configuration_Shared.h]
2017-12-19 MQTT Status topics and so on
    [Configuration_DUE.h, Configuration_MEGA.h, Configuration_MEGA_MiniBoard.h, Configuration_Shared.h]
2017-12-22 First version of feedback module
    [Configuration_DUE.h, Configuration_MEGA.h, Configuration_MEGA_MiniBoard.h]
2017-12-22 Added feedback abilities to the execution module
    Feedback about window position and endstops triggered, works through
    RS485
2017-12-25 GSM module tested on DUE + minor fixes
    [Configuration_DUE.h]
2018-01-05 TFT menu minor fixes
    [UTFTMenu.cpp, UTFTMenu.h]
2018-01-25 Board autoselection & buzzer redesign
    [Configuration_DUE.h]
2018-01-31 Ping function for ESP
    [Configuration_MEGA.h]
2018-02-16 Info diode for control module
2018-02-26 ESP AT version setting
    [Configuration_DUE.h, Configuration_MEGA.h, Configuration_MEGA_MiniBoard.h]
2018-02-27 TFT backlight manage
    [Configuration_DUE.h, Configuration_MEGA.h, Configuration_MEGA_MiniBoard.h]
2018-03-08 Transport redesign
    [Configuration_DUE.h, Configuration_MEGA.h, Configuration_MEGA_MiniBoard.h, Configuration_Shared.h]
2018-03-15 BIG, very BIG refactoring
    [Configuration_DEBUG.h, Configuration_DUE.h, Configuration_MEGA.h, Configuration_MEGA_MiniBoard.h, Configuration_Shared.h]
2018-03-21 EEPROM settings
    [Configuration_DUE.h, Configuration_MEGA.h, Configuration_MEGA_MiniBoard.h]
2018-03-22 Power management for soil moisture sensors
    [Configuration_DUE.h, Configuration_MEGA.h, Configuration_MEGA_MiniBoard.h]
2018-03-30 Due configaration changes
    [Configuration_DUE.h]
2018-04-02 small I2C fixes
2018-04-08 Extra reset for TFT display
    [Configuration_DUE.h]
2018-04-18 Fix RF24 compiling for Due
    [UniversalSensors.cpp]
2018-04-18 LoRa support
    [Configuration_DEBUG.h, Configuration_DUE.h, Configuration_MEGA.h, Configuration_MEGA_MiniBoard.h]
2018-04-20 ping GPRS (SIM800)
    [Configuration_DUE.h, Configuration_MEGA.h, Configuration_MEGA_MiniBoard.h]
2018-04-22 External watchdog level settings
    [Configuration_DUE.h, Configuration_MEGA.h, Configuration_MEGA_MiniBoard.h]
2018-04-22 Windows endstops support
    [Configuration_DUE.h, Configuration_MEGA.h, Configuration_MEGA_MiniBoard.h]
2018-04-26 power pins status
2018-04-30 Change date/time on TFT screen
    [Configuration_DUE.h]
2018-05-10 STM32 support (UNTESTED), Nextion enchanchement, I2C rework
    [Configuration_DUE.h, Configuration_MEGA.h, Configuration_MEGA_MiniBoard.h, Configuration_STM32.h, Configuration_Shared.h]
2018-05-10 TFT colors moved to settings
    [Configuration_DUE.h, Configuration_STM32.h]
2018-05-10 Buzzer refactoring
    [Configuration_DUE.h, Configuration_MEGA.h, Configuration_MEGA_MiniBoard.h, Configuration_STM32.h]
2018-05-11 I2C rework
    [Configuration_MEGA.h]
2018-05-11 Due start debug
    [Configuration_DEBUG.h]
2018-05-13 Одинаковая скорость для всех UART
    [Configuration_DUE.h, Configuration_MEGA.h, Configuration_MEGA_MiniBoard.h, Configuration_STM32.h, Configuration_Shared.h]
2018-05-13 Reset via SMS
    [Configuration_Shared.h]
2018-05-13 Отправка СМС при старте контроллера в работу
    [Configuration_DUE.h, Configuration_MEGA.h, Configuration_MEGA_MiniBoard.h, Configuration_STM32.h]
2018-05-13 Nextion fixes
    [Configuration_DUE.h, Configuration_MEGA.h, Configuration_MEGA_MiniBoard.h, Configuration_STM32.h]
2018-05-14 Wire number for DS3231
    [Configuration_DUE.h, Configuration_MEGA.h, Configuration_MEGA_MiniBoard.h, Configuration_STM32.h]
2018-05-14 Wire` initialization
2018-05-15 I2C clock setting
    [Configuration_DUE.h, Configuration_MEGA.h, Configuration_MEGA_MiniBoard.h, Configuration_STM32.h]
2018-05-15 reset sms text change
    [Configuration_Shared.h]
2018-05-17 windows fix
    [Configuration_MEGA.h]
2018-05-17 Settings for hardware configuration #1
    [Configuration_MEGA.h, Configuration_Shared.h]
